znxingbell/DC-DC-Power/dcdc/dcdc.ioc

Mcu.UserName=STM32F334C8Tx
PA0.Signal=ADC1_IN1
PA1.Signal=ADC1_IN2
PA13.Signal=SYS_JTMS-SWDIO
PA14.Signal=SYS_JTCK-SWCLK
PA2.Signal=ADC1_IN3
PA8.Signal=HRTIM1_CHA1
PA9.Signal=HRTIM1_CHA2
PB13.Signal=GPIO_Output
PB14.Signal=GPIO_Output
PB15.Signal=GPIO_Output
PB6.Signal=GPXTI6
PB7.Signal=GPXTI7
PB8.Signal=GPIO_Output
PB9.Signal=GPIO_Output
