znxingbell/DC-DC-Power/dcdc/Core/User/hrtim_manager.cpp

#include "hrtim_manager.hpp"
#include "hrtim.h"

void HRTIM_Init() {
    HAL_HRTIM_WaveformCounterStart(&hhrtim1, HRTIM_TIMERID_MASTER);
    HAL_HRTIM_WaveformCounterStart(&hhrtim1, HRTIM_TIMERID_TIMER_A); 
    //HAL_HRTIM_WaveformOutputStart(&hhrtim1, HRTIM_OUTPUT_TA1 | HRTIM_OUTPUT_TA2); 
    __HAL_HRTIM_MASTER_ENABLE_IT(&hhrtim1, HRTIM_MASTER_IT_MREP);
}

void SetCompareValue(uint32_t cmp1, uint32_t cmp3) {
    hhrtim1.Instance->sTimerxRegs[HRTIM_TIMERINDEX_TIMER_A].CMP1xR = cmp1;
    hhrtim1.Instance->sTimerxRegs[HRTIM_TIMERINDEX_TIMER_A].CMP3xR = cmp3;
}
