znxingbell/DC-DC-Power/dcdc/Core/User/oled.hpp

#pragma once

#include "main.h"
using float32_t = float;

/*引脚配置*/
#define OLED_W_SCL(x)		HAL_GPIO_WritePin(GPIOB, GPIO_PIN_9, (x) ? GPIO_PIN_SET : GPIO_PIN_RESET)
#define OLED_W_SDA(x)		HAL_GPIO_WritePin(GPIOB, GPIO_PIN_8, (x) ? GPIO_PIN_SET : GPIO_PIN_RESET)

void OLED_Init(void);
void OLED_Clear(void);
void OLED_ShowChar(uint8_t Line, uint8_t Column, char Char);
void OLED_ShowString(uint8_t Line, uint8_t Column, const char *String);
void OLED_ShowNum(uint8_t Line, uint8_t Column, uint32_t Number, uint8_t Length);
void OLED_ShowSignedNum(uint8_t Line, uint8_t Column, int32_t Number, uint8_t Length);
void OLED_ShowHexNum(uint8_t Line, uint8_t Column, uint32_t Number, uint8_t Length);
void OLED_ShowBinNum(uint8_t Line, uint8_t Column, uint32_t Number, uint8_t Length);
void OLED_ShowFloat(uint8_t Line, uint8_t Column, float32_t Number, uint8_t IntLength);
