znxingbell/DC-DC-Power/(commit log)

2025-06-22 同步代码部分
2025-07-19 添加adc和时钟
2025-07-22 添加oled和主控制
